Remlly/AGV/Documentatie/Stelmechanisme.JPG

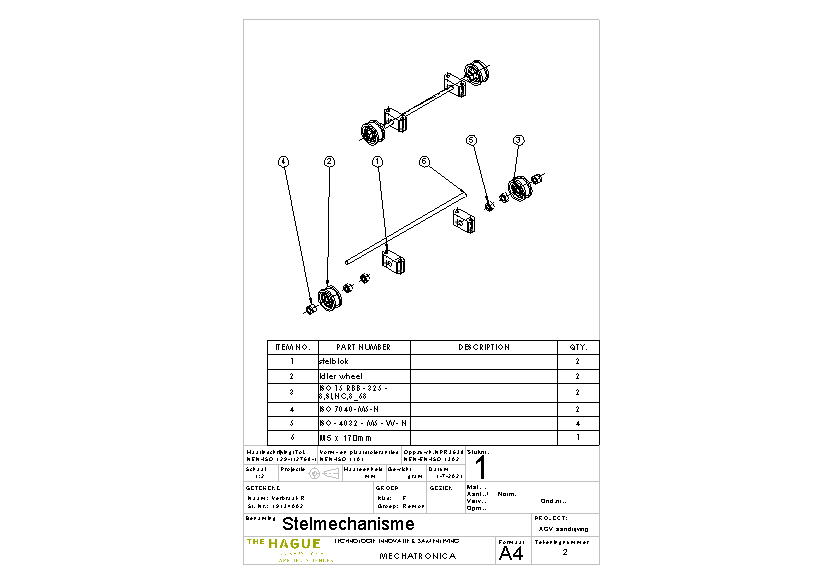
Documentatie/Stelmechanisme.JPG
