Remlly/AGV/Documentatie/Bill of materials.xls

ITEM NO. | PART NUMBER | DESCRIPTION | QTY.
1 | BODY |  | 1
2 | Nema 17 Stepper Motor length 28mm.step |  | 2
3 | ArduinoMega |  | 1
4 | ISO 10669-3-N |  | 14
5 | ISO 4762 M3 x 10 - 10N |  | 10
6 | ISO 4762 M3 x 30 - 18N |  | 4
7 | ISO - 4032 - M3 - W - N |  | 2
8 | As |  | 2
9 | wheel |  | 4
10 | ISO 15 RBB - 325 - 8,SI,NC,8_68 |  | 6
11 | ISO - 4036 - M5 - N |  | 4
12 | ISO 7040-M5-N |  | 4
13 | stelblok |  | 2
14 | Idler wheel |  | 2
15 | ISO - 4032 - M5 - W - N |  | 4
16 | As |  | 1
17 | Belt1-3^Assem1 |  | 1
18 | Belt2-4^Assem1 |  | 1
