Remlly/AGV/STL/Idler wheel.STL

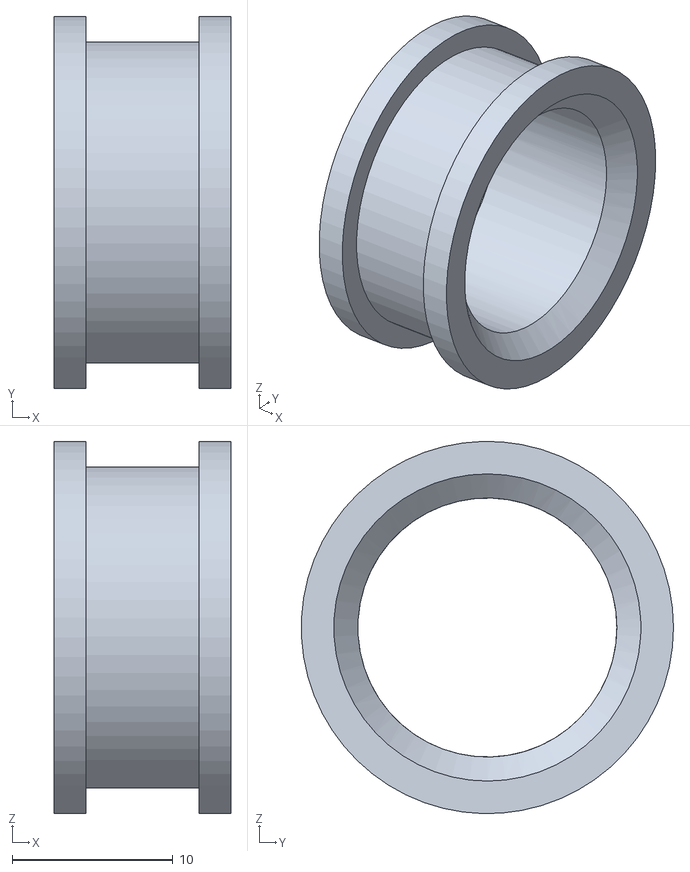
[picture p15: CAD file, 2021-07-02]
STL/Idler wheel.STL
11.0 x 23.1 x 23.1
