Remlly/AGV/STL/BODY.STL

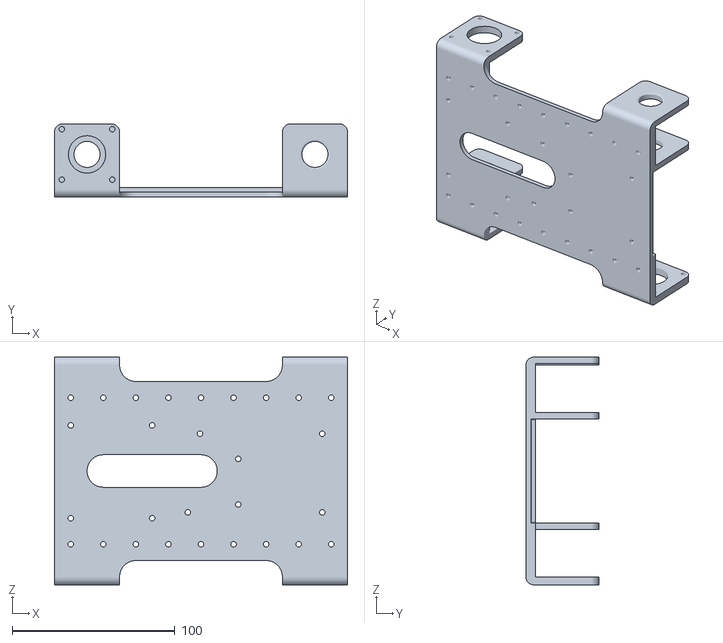
[picture p16: CAD file, 2021-07-02]
STL/BODY.STL
180.0 x 45.0 x 140.0
