Remlly/AGV/STL/wheel.STL

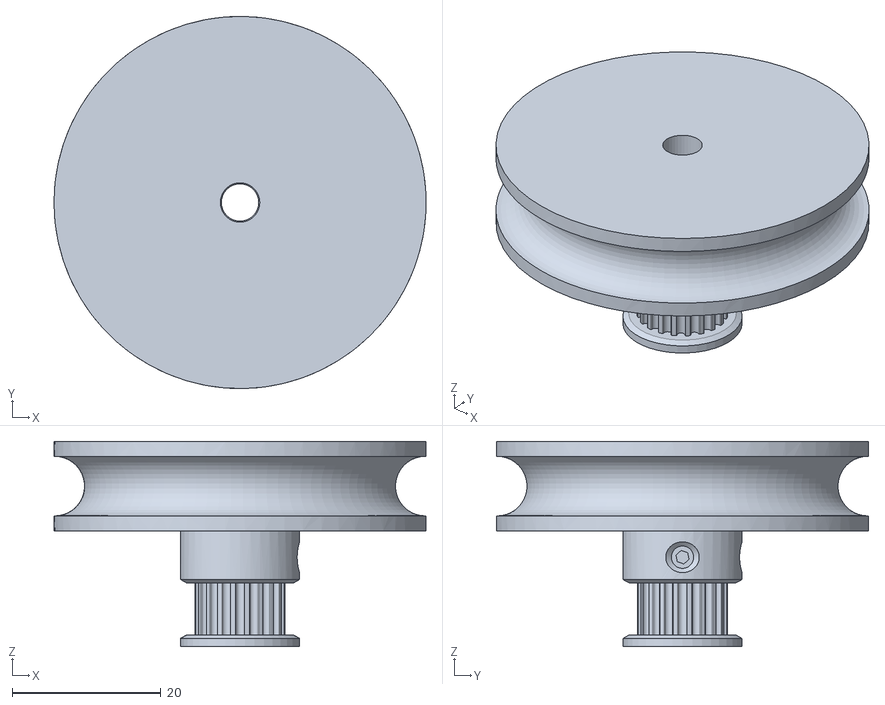
[picture p17: CAD file, 2021-07-02]
STL/wheel.STL
50.0 x 50.0 x 27.5
