Remlly/AGV/STL/stelblok.STL

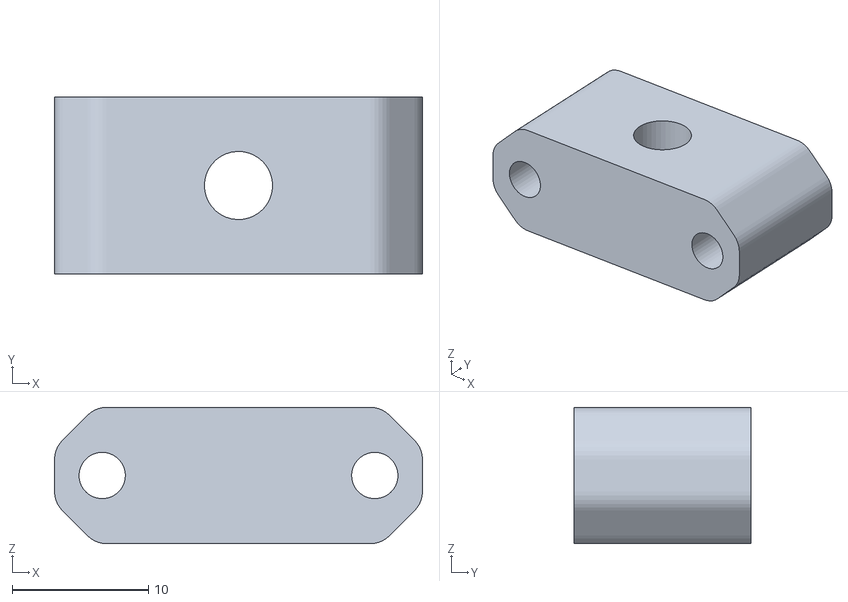
[picture p18: CAD file, 2021-07-02]
STL/stelblok.STL
27.0 x 13.0 x 10.0
