Remlly/AGV/Documentatie/AGV BOM.pdf

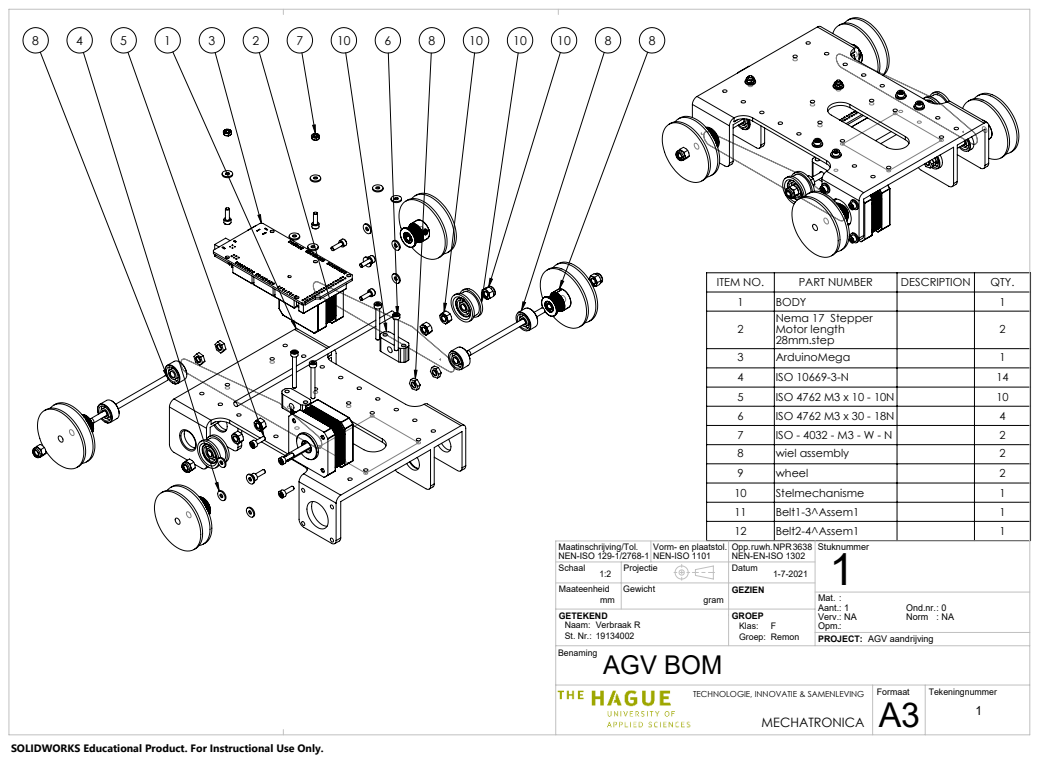
[picture p19: page 1]
AGV BOM; Projectie; Datum 1:2; AGV aandrijving; Norm NA

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

3 | ArduinoMega | | 1
4 | ISO 10669-3-N | | 14
5 | ISO 4762 M3 x 10 - 10N | | 10
6 | ISO 4762 M3 x 30 - 18N | | 4
7 | ISO - 4032 - M3 - W - N | | 2
8 | wiel assembly | | 2
9 | wheel | | 2
10 | Stelmechanisme | | 1
11 | Belt1-3^Assem1 | | 1
12 | Belt2-4^Assem1 | | 1

Maatinschrijving/Tol. NEN-ISO 129-1/2768-1 | Vorm- en plaatstol. NEN-ISO 1101 | Opp.ruwh.NPR3638 NEN-EN-ISO 1302 | 1 Stuknummer
Schaal | | | 1-7-2021
Maateenheid mm | Gewicht gram | | GEZIEN

GETEKEND Naam: Verbraak R St. Nr.: 19134002 | | | GROEP Klas: F Remon Groep:

TECHNOLOGIE, INNOVATIE & SAMENLEVING

SOLIDWORKS Educational Product. For Instructional Use Only.
