Remlly/AGV/Documentatie/wiel assembly.pdf

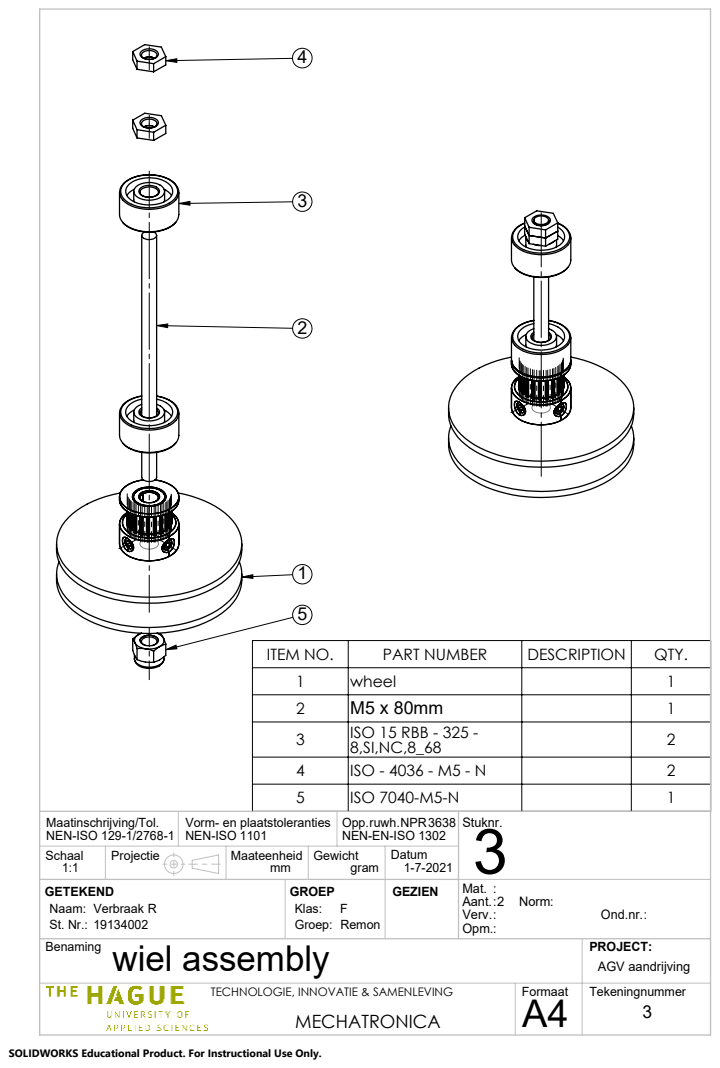
[picture p20: page 1]

ITEM NO. | PART NUMBER | DESCRIPTION | QTY.
1 | wheel | | 1
2 | M5 x 80mm | | 1
3 | ISO 15 RBB - 325 -8,SI,NC,8_68 | | 2
4 | ISO - 4036 - M5 - N | | 2
5 | ISO 7040-M5-N | | 1

Maatinschrijving/Tol. NEN-ISO 129-1/2768-1 | Vorm- en plaatstoleranties NEN-ISO 1101 | Opp.ruwh.NPR3638 NEN-EN-ISO 1302 | 3 Stuknr.

Schaal 1:1 | | | Maateenheid mm | Gewicht gram | 1-7-2021
GETEKEND Naam: Verbraak R St. Nr.: 19134002 | GROEP Klas: F Groep: Remon | GEZIEN | Mat. : Aant. : 2 Norm : Verv. : Ond.nr.: Opm. :

wiel assembly Benaming | PROJECT: AGV aandrijving

TECHNOLOGIE, INNOVATIE & SAMENLEVING | Formaat A4 | Tekeningnummer 3 MECHATRONICA

SOLIDWORKS Educational Product. For Instructional Use Only.
