Remlly/AGV/Documentatie/Stelmechanisme.pdf

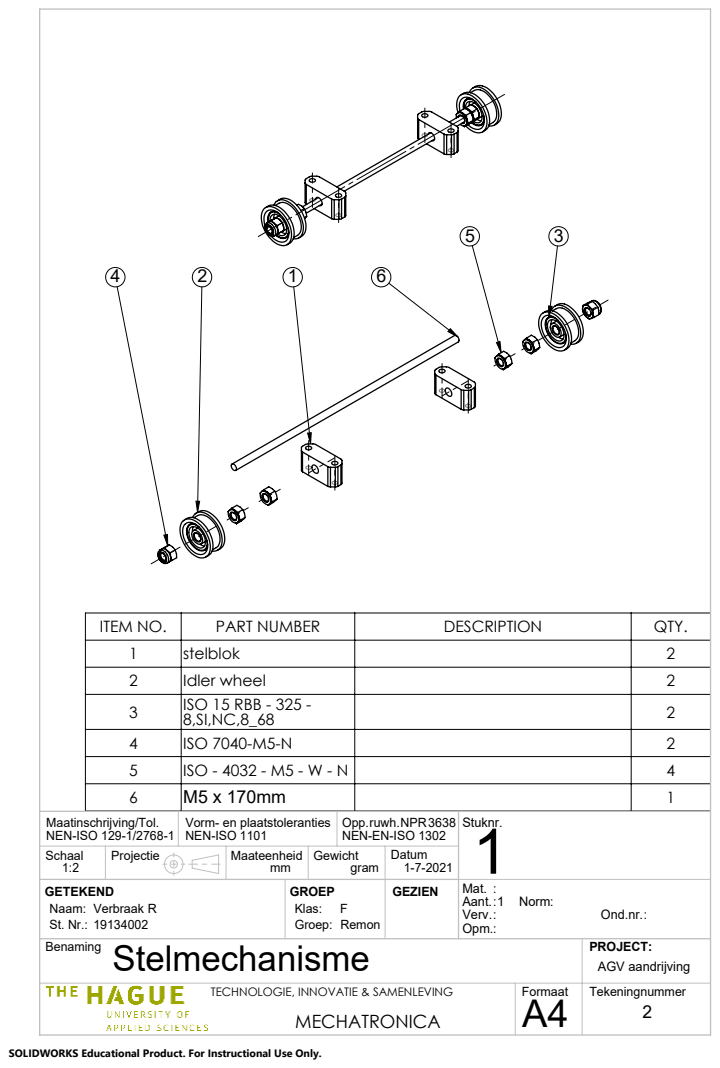
[picture p21: page 1]

ITEM NO. | PART NUMBER | DESCRIPTION | QTY.
1 | stelblok | | 2
2 | Idler wheel | | 2
3 | ISO 15 RBB - 325 -8,SI,NC,8_68 | | 2
4 | ISO 7040-M5-N | | 2
5 | ISO - 4032 - M5 - W - N | | 4
6 | M5 x 170mm | | 1

Maatinschrijving/Tol. NEN-ISO 129-1/2768-1 | Vorm- en plaatstoleranties NEN-ISO 1101 | Opp.ruwh.NPR3638 NEN-EN-ISO 1302 | 1 Stuknr.

Schaal 1:2 | | | Maateenheid mm | Gewicht gram | 1-7-2021
GETEKEND Naam: Verbraak R St. Nr.: 19134002 | GROEP Klas: F Groep: Remon | GEZIEN | Mat. : Aant. : 1 Norm : Verv. : Ond.nr.: Opm. :

Stelmechanisme Benaming | PROJECT: AGV aandrijving

TECHNOLOGIE, INNOVATIE & SAMENLEVING | Formaat A4 | Tekeningnummer 2 MECHATRONICA

SOLIDWORKS Educational Product. For Instructional Use Only.
