Remlly/AGV/Documentatie/wiel assembly.JPG

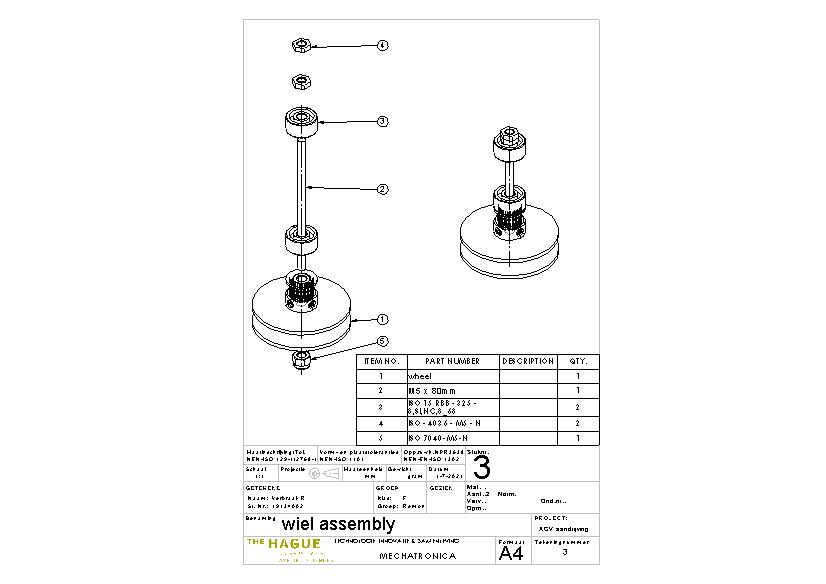
Documentatie/wiel assembly.JPG
