Remlly/AGV/(commit log)

2021-05-31 stappenmotoren update
    code verandert naar DRV8825 driver
2021-05-31 stepper.h
    alles in een andere file gezet.
2021-06-03 Revert "stepper.h"
    This reverts commit 1813014f77105dd6f2d59a564f86387affa940e8.
    [main.c, stepper.c, stepper.h]
2021-06-28 stepper.h reintroductie
